serverdevel/airplay-esp32/docs/ru/index.md

---
title: ESP32 AirPlay 2 Receiver
hide:
  - navigation
---

[English](../index.md) | **Русский**

# AirPlay 2-приёмник на ESP32

**Добавьте AirPlay 2 к усилителю с помощью ESP32-S3 N16R8 и ЦАП PCM5102A.**

Эта прошивка превращает недорогую плату ESP32 в беспроводной AirPlay 2-приёмник.
Подключите его к усилителю или активным колонкам — устройство появится на iPhone, iPad
и Mac так же, как HomePod или телевизор с AirPlay.

Без облачного сервиса и отдельного приложения: выберите устройство и включите музыку.

!!! tip "Плата уже собрана? Установите прошивку прямо сейчас"

    Подключите её по USB и нажмите «Установить». Не нужны среда разработки,
    отдельные загрузки или командная строка: браузер сам запишет прошивку на плату.

<esp-web-install-button manifest="/airplay-esp32/firmware/esp32s3.json">
  <button slot="activate" class="md-button md-button--primary">Установить на ESP32-S3</button>
  <span slot="unsupported">Ваш браузер не поддерживает прошивку по USB. Используйте Chrome, Edge или Opera на компьютере.</span>
  <span slot="not-allowed">Для прошивки требуется защищённое соединение HTTPS.</span>
</esp-web-install-button>

Этот установщик предназначен только для официально поддерживаемой сборки
**ESP32-S3 N16R8 + PCM5102A**. Требуется настольная версия Chrome, Edge или Opera.

<div class="grid cards" markdown>

-   __Собираете впервые?__

    Купите две платы, соедините их и установите прошивку из браузера.

    [Начните здесь](getting-started/index.md)

-   __Проверьте оборудование__

    Для готовой прошивки нужны ESP32-S3 N16R8 и PCM5102A.

    [Поддержка оборудования](boards/index.md)

-   __Что-то не работает?__

    Нет сети настройки, звука или веб-страниц; возникают ошибки сборки.

    [Устранение неполадок](troubleshooting.md)

-   __Хотите изменить проект?__

    Среды сборки, аудиоконвейер и стек протоколов.

    [Архитектура](reference/architecture.md)

</div>

## Что получится

<p align="center">
  Собранный AirPlay-приёмник на ESP32-S3 и PCM5102A с разъёмом 3,5 мм<br>
  <em>Две платы и одна припаянная гребёнка; разъём 3,5 мм подключается к усилителю</em>
</p>

## Как это работает

```mermaid
flowchart LR
    P["iPhone / Mac"]
    W(("Wi‑Fi"))
    E["ESP32<br/><small>эта прошивка</small>"]
    D["ЦАП"]
    S["Аудиосистема"]

    P -->|AirPlay| W --> E -->|I2S| D -->|аналоговый сигнал| S

    classDef hi stroke:#26a69a,stroke-width:3px
    class E hi
```

Телефон обнаруживает в сети AirPlay-приёмник. ESP32 принимает зашифрованный поток,
декодирует и синхронизирует его, после чего передаёт звук по I2S на ЦАП. Аналоговый
выход ЦАП подключается к усилителю. Подробнее — в разделе [«Архитектура»](reference/architecture.md).

## Официально поддерживаемое оборудование

Готовые релизы этого форка собираются и проверяются только для следующей конфигурации:

- **ESP32-S3 N16R8** — 16 МБ flash и 8 МБ octal PSRAM
- **I2S-ЦАП PCM5102A** — подключённый к контактам GPIO10–GPIO14 по нашей схеме

Точные требования к плате, распиновка и положение перемычек приведены на странице
[«ESP32-S3 + PCM5102A»](boards/esp32s3-pcm5102a.md).

Профили других чипов и аудиоплат сохранены в исходном коде как наследие основного
проекта. В этом форке они не тестируются, не входят в релизы и официально не
поддерживаются. Перед самостоятельной сборкой прочитайте раздел
[«Поддержка оборудования»](boards/index.md).

## Возможности

- **AirPlay 2** — устройство отображается в Пункте управления и приложениях с поддержкой AirPlay
- **Интеграция с Apple Home («Дом»)** — приёмник добавляется в «Дом», принимает
  воспроизведение с HomePod и сохраняет сопряжение после перезагрузки
- **Декодирование ALAC и AAC** — музыка и звук в реальном времени, включая Siri и звонки
- **Мультирум** — синхронизация по PTP для одновременного воспроизведения на нескольких устройствах
- **Компенсация акустической задержки** — настройка от −1000 до +1000 мс через
  веб-интерфейс для совмещения звука с HomePod; применяется сразу и сохраняется
- **Веб-интерфейс** — настройка Wi‑Fi, имени устройства и других параметров из браузера
- **Обновления OTA** — обновление по сети; USB нужен только при первой прошивке
- **Выход 48 кГц** — дополнительное преобразование 44,1 → 48 кГц для совместимых ЦАП и мостов S/PDIF
- **Дисплеи** — OLED или цветной TFT 320×170 с названием трека, исполнителем и индикатором воспроизведения
- **Аппаратные кнопки** — воспроизведение/пауза, громкость и переключение треков

### Ограничения

- Только звук: без видео и фотографий AirPlay
- Одно устройство воспроизведения на одну плату ESP32
- Для стабильной передачи нужен уверенный сигнал Wi‑Fi

## Благодарности

- [Shairport Sync](https://github.com/mikebrady/shairport-sync) — эталонная реализация AirPlay
- [openairplay/airplay2-receiver](https://github.com/openairplay/airplay2-receiver) — реализация приёмника AirPlay 2 на Python
- [Espressif](https://github.com/espressif) — платформа ESP-IDF и библиотеки кодеков

## Правовая информация

**Только для некоммерческого использования.** Для коммерческого применения требуется
явное разрешение — см. файл [LICENSE](https://github.com/serverdevel/airplay-esp32/blob/homekit-0.2.1.4/LICENSE).

Это независимый проект, созданный на основе анализа протоколов. Он не связан с Apple Inc.,
не гарантирует совместимость с будущими версиями iOS или macOS и предоставляется без гарантий.
