serverdevel/airplay-esp32/docs/boards/xiao-esp32c5.md

**English** | [Русский](../ru/boards/xiao-esp32c5.md)

# Seeed XIAO ESP32-C5

!!! warning "Inherited and unverified profile"

    This page documents source code inherited from the upstream project. This fork does
    not test this hardware, publish a ready-to-flash image for it or provide official
    support. Build and validate it yourself at your own risk.

The Seeed XIAO ESP32-C5 is a RISC-V board with 8 MB flash, 8 MB PSRAM and **dual-band
WiFi 6**, which makes it attractive where 2.4 GHz is congested. Wire an external I2S DAC
such as a PCM5102A.

!!! warning "No Bluetooth A2DP"

    The ESP32-C5 has Bluetooth LE only, not Bluetooth Classic, so A2DP audio is not
    available on this board.

## Default I2S pins

| Function | GPIO | XIAO label |
| --- | --- | --- |
| Bit clock (BCK) | 8 | D8 |
| Word select (WS / LRCK) | 9 | D9 |
| Data in (DIN) | 10 | D10 |

Change them under **Board Configuration → Pin Configuration** in `menuconfig`.

## Building

There is no release image for this board — build and validate it yourself.

=== "PlatformIO"

    The official `platformio/espressif32` platform does **not** support the ESP32-C5, so
    every environment uses the community
    [pioarduino](https://github.com/pioarduino/platform-espressif32) platform, pinned in
    `platformio.ini`. It bundles ESP-IDF 5.5.5 and PlatformIO downloads it automatically
    on the first build — no extra setup needed.

    ```bash
    pio run -e esp32c5-xiao -t upload
    pio run -e esp32c5-xiao -t uploadfs
    ```

=== "ESP-IDF"

    ```bash
    idf.py set-target esp32c5
    idf.py -DSDKCONFIG_DEFAULTS="config/sdkconfig.defaults;config/sdkconfig.defaults.esp32c5" build flash monitor
    ```

## Related

- [Build environments](../reference/build-environments.md)
- [Custom board configuration](custom.md)
