serverdevel/airplay-esp32/docs/ru/features/bluetooth.md

[English](../../features/bluetooth.md) | **Русский**

# Bluetooth A2DP

!!! warning "Недоступно в поддерживаемом релизе этого форка"

    В поддерживаемой сборке ESP32-S3 N16R8 нет Bluetooth Classic, поэтому A2DP
    невозможен. Страница описывает унаследованный код для непроверенных профилей ESP32.

Платы ESP32-based могут принимать аудио через **Bluetooth Classic A2DP**, что позволяет любому телефону
планшет или ноутбук транслируют музыку без устройства Apple. Ресивер выглядит стандартно.
Динамик Bluetooth с метаданными AVRCP и регулировкой громкости.

!!! warning "Только ESP32"

    Bluetooth Classic существует только на оригинальном ESP32. ESP32-S3, S2 и C5 имеют
    Bluetooth LE или вообще ничего, поэтому A2DP там недоступен. Общий `esp32s3`
    сборка не содержит поддержки Bluetooth.

Стек Bluedroid используется для A2DP. Он очень жёсткий и на ОЗУ, и на флэш, вот почему
Сборки Bluetooth представляют собой отдельные среды, а не включаются повсюду.

## Как это работает

- AirPlay и Bluetooth сосуществуют в прошивке, но являются **взаимоисключающими во время выполнения**
- При подключении устройства Bluetooth работа AirPlay автоматически приостанавливается.
- При отключении AirPlay возобновляет работу.
- Обнаружение Bluetooth отключено во время активного сеанса AirPlay, поэтому телефон теряется.
  не могу прервать воспроизведение
- AVRCP обеспечивает синхронизацию громкости и метаданные дорожки (исполнитель, название, альбом) для отображения.
- Том Bluetooth сохраняется в NVS и восстанавливается при повторном подключении.

[Диаграмма состояний сосуществования](../reference/architecture.md#runtime-coexistence-rules)
показывает, как два протокола передаются друг другу.

## Сопряжение

Устройство объявляет то же имя, что и имя вашего устройства AirPlay, которое вы установили в Интернете.
интерфейс. Для сопряжения используется фиксированный PIN-код, `05032026` по умолчанию, который можно настроить в разделе
**Конфигурация Bluetooth** в `menuconfig`.

Secure Simple Pairing (SSP) можно дополнительно включить для устройств Bluetooth 2.1+, что
использует числовое подтверждение вместо PIN-кода. SSP нужен дисплей для отображения подтверждения
число, и это еще не реализовано.

## Среды сборки

| Среда сборки | Совет | Особенности |
| --- | --- | --- |
| `squeezeamp-bt` | SqueezeAMP | AirPlay + Bluetooth |
| `esparagus-audio-brick-bt` | Esparagus Audio Brick, версия ESP32 | AirPlay + Bluetooth + Ethernet |
| `esparagus-louder-bt` | Esparagus Louder | AirPlay + Bluetooth |
| `esp32wrover-dev` | Фринове ESP32-WROVER | AirPlay + Bluetooth, флэш-память 4 МБ |
| `smartamp` | SmartAmp | AirPlay + Bluetooth, флэш-память 4 МБ |

Bluetooth включается путем наложения `config/sdkconfig.defaults.bt` на настройки платы по умолчанию. Чтобы добавить это
на [пользовательскую плату](../boards/custom.md), включите этот файл в свой
Цепь `SDKCONFIG_DEFAULTS`.

Платы продаются как в ревизии ESP32, так и в версии ESP32-S3.
[Esparagus Audio Brick](../boards/esparagus-audio-brick.md) и Громче — есть `-bt`
среда только для ESP32. В версии S3 включать нечего.

## Кнопки при воспроизведении по Bluetooth

В отличие от AirPlay, [аппаратные кнопки](buttons.md) полностью работают с Bluetooth независимо от
настройки протокола, поскольку сквозной канал AVRCP передает команды воспроизведения/паузы и пропуска дорожки
изначально.
