serverdevel/airplay-esp32/dist/README-RU.md

# AirPlay 2 + Apple Home, версия 0.2.1.4

Сборка основана на `airplay-esp32` v0.2.1 и предназначена для платы
ESP32-S3 N16R8 с внешним PCM5102A. Она добавляет постоянную привязку
AirPlay-приёмника к Apple Home и ручную компенсацию постоянной задержки
домашнего кинотеатра в диапазоне от −1000 до +1000 мс.

Это позволяет добавить приёмник в приложение «Дом» и просить Siri на HomePod
добавить его к текущему воспроизведению. Это не превращает приёмник и HomePod
в стереопару: Apple разрешает стереопары только из совместимых моделей
HomePod. Здесь используется синхронная AirPlay 2 группа (multiroom).

## Какой файл использовать

Готовые файлы прошивки приложены к GitHub Release версии `0.2.1.4`.

- `airplay2-receiver-esp32s3-v0.2.1.4-ota.bin` — безопасное
  обновление через текущую веб-страницу устройства. Сохраняет Wi-Fi, имя и
  остальные настройки. Новая главная веб-страница встроена в OTA, поэтому это
  рекомендуемый вариант для обновления с версии 0.2.1.3.
- `airplay2-receiver-esp32s3-v0.2.1.4-spiffs.bin` — отдельный образ остальных
  веб-файлов. Для обновления с 0.2.1.3 не требуется.
- `airplay2-receiver-esp32s3-v0.2.1.4-full.bin` — полный образ на
  8 MiB для последовательной прошивки с адреса `0x0`. Он перезапишет NVS,
  поэтому Wi-Fi и настройки придётся вводить заново. Использовать для чистой
  установки или восстановления, только на ESP32-S3 с флеш-памятью не менее
  8 MiB (сборка настроена для 16 MiB).

## Обновление по Wi-Fi

1. Откройте IP-адрес приёмника в браузере.
2. В разделе **Firmware Update** выберите файл с окончанием `-ota.bin`.
3. Нажмите **Upload Firmware** и дождитесь перезагрузки.
4. Проверьте, что в сведениях о системе указана версия `0.2.1.4`, приёмник
   снова появился в меню AirPlay и обычное воспроизведение работает.

Новая главная страница с настройкой синхронизации встроена непосредственно в
OTA-образ. После обновления достаточно перезагрузить страницу браузера. Сбросить
привязку Apple Home также можно командой:

```bash
curl -X POST "http://IP_ПРИЁМНИКА/api/home/reset"
```

## Добавление в Apple Home

Для первичной привязки используйте один из домашних iPhone с современной
версией iOS. iPhone с iOS 16.3 для этого теста лучше не использовать.

1. iPhone, HomePod и ESP32 должны находиться в одной обычной локальной сети.
   Гостевая сеть и изоляция Wi-Fi-клиентов должны быть выключены.
2. В приложении «Дом» откройте настройки дома → **Колонки и телевизоры**
   (Allow Speaker & TV Access). Выберите доступ для устройств в той же сети и
   временно отключите требование пароля.
3. Нажмите `+` → **Добавить аксессуар** → **Другие варианты**.
4. Выберите имя AirPlay-приёмника и назначьте ему комнату, например
   «Гостиная». Название можно оставить «Кинотеатр».
5. Подождите 30–60 секунд и закройте/снова откройте «Дом», если устройство не
   появилось сразу.

После добавления попробуйте на HomePod:

- «Добавь кинотеатр»;
- «Играй также в кинотеатре»;
- «Перенеси музыку в кинотеатр».

Первая и вторая команды должны создать AirPlay-группу с HomePod; третья может
перенести воспроизведение вместо одновременной игры — это зависит от формулировки
Siri и выбранных комнат.

## Компенсация задержки домашнего кинотеатра

1. Запустите параллельное воспроизведение на HomePod и «Кинотеатре».
2. Откройте IP-адрес приёмника и найдите **AirPlay Synchronization**.
3. Если кинотеатр слышен раньше HomePod, задайте положительное значение. Если
   кинотеатр запаздывает, задайте отрицательное значение.
4. Нажмите **Apply**. Изменение применяется без перезагрузки; в этот момент
   возможен один короткий пропуск или пауза.
5. Сначала подбирайте шагом 50–100 мс, затем 5–10 мс. Значение сохраняется в
   NVS и продолжает действовать после перезагрузки.

Настройка исправляет постоянный сдвиг. Она не устраняет переменную задержку,
если ресивер домашнего кинотеатра сам меняет режим обработки сигнала.

## Если добавление не удалось

1. Удалите неудачно созданный аксессуар из «Дома», если он там появился.
2. Выполните сброс привязки кнопкой **Reset Home Pairing** или запросом
   `/api/home/reset` выше.
3. Перезагрузите ESP32 и повторите добавление с нового iPhone.
4. Откройте `http://IP_ПРИЁМНИКА/logs` и сохраните строки с метками
   `hap_`, `hap_pair_mgmt`, `hap_verify` и `rtsp`.

Базовая версия 0.2.1.3 проверена на реальном ESP32-S3 N16R8 с PCM5102A и
HomePod OS 27.0: добавление в Apple Home, перенос воспроизведения с HomePod и
параллельное воспроизведение в AirPlay-группе работают. В версии 0.2.1.4 к ней
добавлена ручная акустическая калибровка; точное значение нужно подобрать на
реальном домашнем кинотеатре.

## Контрольные суммы SHA-256

```text
06c5d24539da660a4b26f2fb9a90408fa9ecdc634a5125b49cdd1ece64787075  airplay2-receiver-esp32s3-v0.2.1.4-full.bin
a817c9d9be521f7bf0f7aff5aef759b827de46e934a4b7d1d3b2a331f714bdc1  airplay2-receiver-esp32s3-v0.2.1.4-ota.bin
eef89e670b03820c35afeaf72f536d5241e8ea5edc1c0faee7c680307429d073  airplay2-receiver-esp32s3-v0.2.1.4-spiffs.bin
```
