serverdevel/airplay-esp32/docs/ru/boards/esparagus-audio-brick.md

[English](../../boards/esparagus-audio-brick.md) | **Русский**

# Esparagus Audio Brick

!!! warning "Унаследованный непроверенный профиль"

    Эта страница описывает исходный код, унаследованный от основного проекта. Данный
    форк не тестирует эту плату, не публикует для неё готовый образ и не предоставляет
    официальную поддержку. Самостоятельная сборка и проверка выполняются на ваш риск.

[Esparagus Audio Brick](https://github.com/sonocotta/esparagus-media-center/?tab=readme-ov-file#esparagus-audio-brick-prototype)
построен на базе ЦАП и усилителя TI **TAS5825M** класса D. Как и SqueezeAMP, он
не нужен внешний ЦАП — подключайте динамики напрямую.

Плата существует в версиях **ESP32** и **ESP32-S3**. Аудио дизайн
то же самое; распиновки нет, и нет того, что могут сделать эти два чипа — см.
[Назначения GPIO по умолчанию](#default-gpio-assignments) и [Варианты](#variants).

Некоторые блоки оснащены TI **TAS5805M**, а не TAS5825M. Это то же самое
семья и тот же водитель, но это не одна и та же часть: см.
[Платы TAS5805M](#tas5805m-boards) за то, что она здесь делает и чего не делает.

## Функции

- TAS5825M со встроенным DSP и 15-полосным параметрическим эквалайзером (25 Гц – 16 кГц)
- Аппаратный регулятор громкости с настраиваемым максимальным уровнем
- Обнаружение неисправности динамика с автоматическим отключением звука и восстановлением
- Автоматическое управление состоянием питания (глубокий сон/ожидание/воспроизведение), управляемое состоянием сеанса AirPlay.
- флэш-память 8 МБ
- [Bluetooth A2DP](../features/bluetooth.md) только в версии **ESP32** — у S3 нет
  Bluetooth Классическая магнитола, поэтому сборки `-bt` для нее нет.
- [W5500 SPI Ethernet](../features/ethernet.md) с автоматическим аварийным переключением WiFi, на обоих
  редакции

## Прошивка

=== "Образ релиза"

    Этот форк не публикует готовый образ. Соберите и проверьте профиль самостоятельно.

=== "PlatformIO"

    ```bash
    # ESP32 — AirPlay + Ethernet
    pio run -e esparagus-audio-brick -t upload
    pio run -e esparagus-audio-brick -t uploadfs

    # ESP32 — AirPlay + Bluetooth + Ethernet
    pio run -e esparagus-audio-brick-bt -t upload
    pio run -e esparagus-audio-brick-bt -t uploadfs

    # ESP32-S3 — AirPlay + Ethernet (no Bluetooth on this chip)
    pio run -e esparagus-audio-brick-s3 -t upload
    pio run -e esparagus-audio-brick-s3 -t uploadfs

    # Serial monitor
    pio run -e esparagus-audio-brick -t monitor
    ```

=== "ESP-IDF"

    ```bash
    # ESP32 revision
    idf.py set-target esp32
    idf.py -DSDKCONFIG_DEFAULTS="config/sdkconfig.defaults;config/sdkconfig.defaults.esparagus-audio-brick" build

    # ESP32-S3 revision
    idf.py set-target esp32s3
    idf.py -DSDKCONFIG_DEFAULTS="config/sdkconfig.defaults;config/sdkconfig.defaults.esparagus-audio-brick-s3" build

    idf.py -p /dev/ttyUSB0 flash
    ```

## Назначения GPIO по умолчанию

У двух ревизий нет общей распиновки, поэтому выберите столбец, соответствующий вашей плате. ESP32
столбец — `config/sdkconfig.defaults.esparagus-audio-brick`, столбец S3
`config/sdkconfig.defaults.esparagus-audio-brick-s3`.

| Функция | ESP32 | ESP32-S3 | Заметки |
| --- | :-: | :-: | --- |
| I2S BCK | 26 | 14 | Битовые часы |
| I2S WS | 25 | 15 | Выбор слова (LRCLK) |
| I2S ДЕЛАТЬ | 22 | 16 | Последовательные аудиоданные |
| I2C ПДД | 21 | 8 | Управление ЦАП (TAS5825M) |
| I2C СКЛ | 27 | 9 | Управление ЦАП (TAS5825M) |
| Предупреждение ЦАП | 36 | 4 | TAS5825M выход предупреждения, вход |
| Ошибка динамика | 39 | 18 | TAS5825M FAULTZ, вход |
| Светодиод состояния | 12 | 21 | Адресный RGB |
| СПИ СКЛК | 18 | 12 | Совместно используется Ethernet и дисплей |
| СПИ МОСИ | 23 | 11 | Совместно используется Ethernet и дисплей |
| СПИ МИСО | 19 | 13 | Только Ethernet |
| Ethernet CS | 5 | 10 | W5500 |
| Ethernet ИНТ | 35 | 6 | W5500 |
| Ethernet РСТ | 14 | 5 | W5500 |
| Показать CS | 15 | 47 | SH1106 OLED |
| Дисплей постоянного тока | 4 | 38 | SH1106 OLED |
| Показать РСТ | 32 | 48 | SH1106 OLED |

!!! note "GPIOs 34–39 доступны только для ввода на ESP32"

    В версии ESP32 линии неисправности, предупреждения и прерывания Ethernet
    GPIOs 35–39, которые предназначены только для входа и не имеют внутренней подтяжки. Совет предоставляет
    внешние подтягивания. Версия S3 не имеет такого ограничения на используемые контакты.

Audio Brick Dual — это плата S3 с третьей распиновкой: у нее есть два усилителя и нет
FAULTZ возвращается к MCU, вместо этого тратя GPIO 18 и 17 на два включения ЦАП. См.
[Esparagus Audio Brick Dual](esparagus-audio-brick-dual-dac.md).

Сборка автоматически выбирает драйвер TAS58xx (`CONFIG_DAC_TAS58XX`). Водитель
автоматически определяет усилитель при запуске: 0x4C–0x4F для TAS5825M, 0x2C–0x2F для
ТАС5805М. Затем он подтверждает предположение по идентификатору кубика и предупреждает, если они не согласны.

## Платы TAS5805M

Некоторые кирпичи вместо этого имеют **TAS5805M**. Водитель обнаруживает его, управляет им и выдает
своя собственная последовательность инициализации, поэтому плата играет, а также ее громкость, отключение звука и 15-полосная биквадратная цепочка
все работает через страницу [Эквалайзер](#equaliser) точно так же, как на TAS5825M.

Две вещи не переносятся:

!!! warning "На TAS5805M нет дампов PPC3"

    Дамп воспроизводит *поток процесса*, что является функцией TAS5825M — TAS5805M не имеет
    регистр потока-выбора и размещает его коэффициенты по-другому, поэтому экспортируется дамп
    ибо одна часть будет писать мусор в другую. Водитель проверяет модель и
    пропускает файл, а не рискует. Эквивалента load не существует, поэтому
    [Полная настройка PPC3](#full-ppc3-tuning) просто не применима:
    Страница [Эквалайзер](#equaliser) содержит все доступные настройки, которые для большинства
    в любом случае сборки — это весь путь сигнала.

**Входной микшер** также предназначен только для TAS5825M. Суммирование в моно или подача одного канала на оба
Выходы выполняются в микшере DSP, и здесь реализован только микшер TAS5825M, поэтому
TAS5805M пропускает стереопару напрямую и записывает предупреждение, если его об этом попросят.
что-нибудь еще. Это также означает, что схема кроссовера не требует суммирования или одноканального подключения.
Feed — те, которые маршрутизируют пару как есть, все еще работают.

## Эквалайзер

Платы TAS5825M предоставляют доступ к 15 каскадным биквадратным секциям ЦАП через сеть устройства.
интерфейс на `/bq`, по одному фильтру на секцию, на выход и на усилитель. Каждый
Секция может быть пиковым фильтром, полкой, фильтром низких или высоких частот в шести выравниваниях, полосой
проход, метка, фазовый сдвиг или пять необработанных коэффициентов. Модели фильтров совпадают
PurePath Console 3, и коэффициенты пересчитываются всякий раз, когда частота дискретизации I2S
изменения. Два выхода микросхемы называются A и B — какой из них передает сигнал влево, вправо.
или сумма — это настройка маршрутизации, а не фиксированное назначение. A и B могут быть объединены или
настраивается отдельно. Редактирование только перерисовывает график ответов: **Применить** отправляет фильтры.
к усилителям, чтобы вы могли их услышать, а функция **Commit to flash** позволяет им пережить
перезагрузка. **Восстановить** возвращает то, что находится во флэш-памяти. Для формирования простого тона **Load
15-полосный эквалайзер** дополняет цепочку плоским графическим эквалайзером — по одной секции пиков на каждую.
полоса от 20 Гц до 16 кГц — остается установить только коэффициент усиления. Он заполняет форму и
ничего больше, поэтому усилитель слышит его только один раз.

Кроссоверы состоят из тех же секций, поэтому разделение на двухполосный динамик или сабвуфер просто необходимо.
проход верхних частот на одном усилителе и проход нижних частот на другом. **Создать кроссовер** делает это
для вас: выберите способ подключения драйверов — оба диапазона на одном усилителе, по одному усилителю на каждый.
динамик, высокочастотные динамики на одном усилителе и низкочастотные динамики на другом или сателлиты плюс
сабвуфер — затем частота разделения и выравнивание: Линквиц-Райли на 12 или
24 дБ на октаву, Баттерворта на 6, 12 или 24 или Бесселя на 12. Пишет фильтры
к каждому выходу, который касается разделения, устанавливает согласование группировки и входной маршрутизации и
оставляет фильтры включенными, поэтому ничего не слышно, пока они не будут применены. Apply всегда выдвигает все
усилители, поэтому кроссовер, объединяющий оба, никогда не сможет работать пополам. Макеты
правила подключения не предлагаются — мостовой усилитель не имеет отдельных A и B для
разделить поперек.

Более крутые выравнивания требуют больше слотов, поскольку секции располагаются каскадом. Линквиц-Райли — это два.
каскадировал Баттерворты половины своего порядка, поэтому LR2 - это два Баттерворта 1-го порядка - настоящие
полюса, которые схлопываются в один биквадрат при Q 0,5, тогда как LR4 представляет собой два полюса Баттерворта 2
секции при Q 0,707 и не могут быть сложены в одну. Вот почему 24 дБ на октаву
разделение показывает два раздела Баттерворта 2, а не один Линквиц-Райли 2: оба будут
наклон составляет 24 дБ на октаву, но только пара Баттерворта находится на 6 дБ ниже в углу,
именно это позволяет двум ветвям суммироваться. Две секции Linkwitz-Riley 2 будут
Там 12 дБ и сумма 6 дБ короче.

В каждом разделе также есть поле **Inv**, которое меняет полярность. Застройщик устанавливает это
сам и не предлагает его как выбор, потому что это решает расклад: на
В углу ветви расположены на 180° друг от друга с уровнем шума 12 дБ на октаву и требуют противоположной полярности для
сумма плоская, но они снова находятся в фазе на уровне 24, где инвертирование вместо этого приведет к образованию зазубрины.
Только одна часть ветки всегда несет его — полярность принадлежит цепи, и
поскольку секции умножаются, инвертирование четного их числа возвращает к нулю.
Коробка все еще там вручную для драйверов, подключенных не по фазе. Часть осталась на обходе
при отмеченном Inv происходит простая смена полярности и больше ничего не стоит.

### Уменьшение размера

**Подгонка к измерению...** превращает измеренный отклик в поправку. Загрузить частоту
экспорт ответа — текст REW, или любой файл с частотой и уровнем в первых двух
колонны — и слесарь ищет выступающие фильтры и полки, которые ее выравнивают,
затем записывает их в цепочку. Подгоняется только форма, а не абсолютный уровень.
График отклика получает два наложения: измерение в том виде, в котором оно было, и в том виде, в каком оно было раньше.
исправлено, поэтому можно оценить соответствие до того, как что-либо будет применено.

Три настройки имеют большее значение, чем остальные. Диапазон соответствия определяет, куда будут направлены усилия:
драйвер скатывается на своих концах на большую величину, чем может отменить любой фильтр, и выходит за пределы диапазона
Wide тратит фильтры на борьбу с тем, что вместо коррекции полосы, которую закрывает драйвер —
Страница говорит об этом, когда измерение уже значительно опустилось до нижнего предела. Сглаживающие наборы
сколько деталей гоняется, а шестая октава сохраняет режимы помещения, игнорируя
тонкая структура, которая движется вместе с микрофоном. Применяются ограничения повышения и понижения
к суммированной поправке, а не к какому-то одному фильтру, и результат сообщает, насколько
было использовано повышение, поэтому такая же величина может снизиться до уровня этого выхода, чтобы сохранить
высота над головой.

**Держать первые N секций** защищает начало цепи. Подгонка заменяет все
после этого отсчета, поэтому на динамике с двухканальным усилением оставьте кроссовер, измерьте каждую полосу
это и вписаться в то, что осталось; счет заполняется из любых низких или высоких проходов
уже сидит на вершине цепочки. Сохраняемые секции — это слоты, которых у установщика быть не может.
поэтому **Используемые фильтры** ограничиваются тем, что остается — кроссовер оставляет 24 дБ на октаву.
13 из 15. Установленные фильтры настроены так же, как и любой другой монтаж — ничего не слышно, пока
применяется, и ничего не сохраняется после перезагрузки до тех пор, пока не будет зафиксировано.

Каждый усилитель имеет свою собственную входную маршрутизацию: стереопара как есть, суммированная с
`(L+R)/2` или один канал подается на оба выхода. Мостовой усилитель управляет одним голосом
катушка, поэтому на нее всегда подается один канал и по умолчанию используется сумма; группировка является неявной
стерео вариант не предлагается. Объединенный график ответов вверху страницы.
отображает каждый активный выход вместе, поэтому можно определить разброс кроссовера по обоим усилителям.
читать как одну картинку.

**Показать сумму выходных данных** добавляет еще одну кривую к этому графику. Питание выходов
отдельные драйверы добавляются как векторы, а не как кривые, поэтому две ветви, каждая из которых выглядит правильно
в одиночку все еще может отменить то место, где они перекрываются - и обе кривые тоже выглядят одинаково
в обход, поэтому его легко пропустить. Сумма берется по комплексу
Вместо этого ответ: кроссовер правильный, когда он ровно проходит поворот, а провал
значит ветки ругаются, поэтому одной из них нужен **Inv**. След знает
только фильтры, а не динамики, их расстояние или помещение, так что это показывает, что
кроссовер нацелен на то, а не на то, что услышит микрофон.

Уровни задаются в разделе Volume. Мастер — это том AirPlay, который перемещается.
все вместе. Под ним каждый выход имеет свой собственный уровень и приглушение, применяемое в
Входной микшер DSP опережает фильтры — поэтому они только ослабляют и не требуют затрат на фильтр.
высота над головой. Используйте их для сопоставления драйверов с разной чувствительностью. Уровни и приглушения берут
вступают в силу немедленно и сохраняются в NVS независимо от фиксации фильтра.

## Полная конфигурация PPC3

!!! info "Только TAS5825M"

    Весь этот раздел относится к платам, оснащенным TAS5825M. Кирпич TAS5805M не имеет
    поток процесса для воспроизведения и игнорирует эти файлы \u2014 см.
    [Платы TAS5805M](#tas5805m-boards).

Страница эквалайзера охватывает пятнадцать биквадов на канал, кроссовер и уровни.
это весь путь сигнала для большинства сборок. Настроенный дамп из TI PurePath Console 3
идет дальше: это полная конфигурация устройства — тактирование, формат I2S, процесс
поток выбирает и каждый коэффициент — чтобы он дошел до блоков, которые веб-интерфейс не делает
разоблачить. Сюда входят потоки, карта коэффициентов которых TI никогда не публиковала, потому что дамп
воспроизводит записи в собственный регистр TI, а не адреса, которые нам нужно знать.

При загрузке драйвер ищет дамп на SPIFFS и, если он есть, воспроизводит его *вместо этого.
из* встроенной последовательности инициализации. PPC3 записывает каждый коэффициент со скоростью потока.
экспортируется, поэтому настройка 48 кГц, воспроизводимая на частоте 44,1 кГц, снижает каждый угол примерно на 8%: имя
файл по его скорости, и драйвер выбирает тот, который соответствует тому, что он воспроизводит.

| Файл | Применяется к |
| --- | --- |
| `/spiffs/hf/tas5825m_fw-44100.bin` | единственный усилитель, или первый из двух, на 44,1 кГц |
| `/spiffs/hf/tas5825m_fw-48000.bin` | то же, на частоте 48 кГц |
| `/spiffs/hf/tas5825m_fw0-44100.bin` | первый усилитель на плате с двумя ЦАП, частота 44,1 кГц |
| `/spiffs/hf/tas5825m_fw1-44100.bin` | второй усилитель на плате с двумя ЦАП, частота 44,1 кГц |

Отбросьте суффикс `-<rate>` — `tas5825m_fw.bin`, `tas5825m_fw0.bin` — для дампа, который
должен обслуживать каждую ставку. Эти имена являются запасными, их ищут только один раз.
файлы, зависящие от скорости, совпадают, поэтому установка с одной скоростью продолжает работать без изменений. Процесс
поток — это функция TAS5825M, поэтому драйвер ищет что-либо из этого только в этой части —
см. [платы TAS5805M](#tas5805m-boards).

Чтобы установить один:

1. Настройте деталь в PPC3 и экспортируйте либо журнал I2C (`.cfg`), либо заголовок C для каждого
   частота дискретизации, которую вы хотите охватить.
2. Преобразуйте его:
   ```bash
   python3 components/dac_tas58xx/ppc3_convert.py my_tuning_44k1.cfg -o tas5825m_fw-44100.bin
   ```
Журнал, который управляет обоими усилителями, содержит записи для каждого, поэтому выберите тот, у которого
   `--dev 98` или `--dev 9a` и преобразуйте его дважды.
3. Скопируйте результат в `data/hf/` для последовательной прошивки или загрузите его через WiFi:
   ```bash
   curl -X POST "http://<device-ip>/api/fs/upload?path=/spiffs/hf/tas5825m_fw-44100.bin" \
        --data-binary @tas5825m_fw-44100.bin
   ```
4. Перезагрузитесь.

Удалите файл, чтобы вернуться к встроенному потоку.

!!! warning

    Дамп владеет конфигурацией, поэтому драйвер перестает писать свой собственный путь сигнала.
    по умолчанию и вместо этого доверяет настройке. Неправильно указана тактовая частота или формат I2S.
    и эта роль не сыграет — в первый раз оставьте последовательную консоль подключенной.

Биквадратные адреса идентичны во всех документированных потоках как на TAS5825M, так и на
TAS5805M, поэтому страница эквалайзера продолжает работать поверх дампа. Дамп, который выбирает
недокументированный поток является исключением: ничто не гарантирует, что его коэффициенты будут жить там, где
страница ожидает их.

## Варианты

| Среда сборки | Чип | Bluetooth | Образ релиза | Заметки |
| --- | --- | :-: | :-: | --- |
| `esparagus-audio-brick` | ESP32 | — | — | AirPlay + Ethernet |
| `esparagus-audio-brick-bt` | ESP32 | да | — | Добавляет Bluetooth A2DP |
| `esparagus-audio-brick-s3` | ESP32-S3 | — | — | Распиновка S3, PSRAM, на этом чипе нет Bluetooth Classic |
| `esparagus-audio-brick-dual-dac` | ESP32-S3 | — | — | [Dual](esparagus-audio-brick-dual-dac.md), два усилителя: стерео по 0x4C, второй по 0x4D |
| `esparagus-audio-brick-dual-uac` | ESP32-S3 | — | — | [Dual](esparagus-audio-brick-dual-dac.md) в качестве аудиоустройства USB |

Ни один вариант в этой таблице не публикуется и не тестируется данным форком.

Bluetooth Classic существует только на оригинальном ESP32, поэтому в сборке `-bt` нет S3.
эквивалент; блок S3 подключается к сети через Ethernet или WiFi. У Dual есть два
усилители и собственная распиновка, а также получает [свою страницу](esparagus-audio-brick-dual-dac.md).

### Esparagus Louder

Esparagus Louder — это усилитель той же конструкции, но на собственной плате.

| Среда сборки | Чип | Bluetooth | Образ релиза |
| --- | --- | :-: | :-: |
| `esparagus-louder` | ESP32 | — | — |
| `esparagus-louder-bt` | ESP32 | да | — |
| `esparagus-louder-s3` | ESP32-S3 | — | — |

```bash
pio run -e esparagus-louder-s3 -t upload
pio run -e esparagus-louder-s3 -t uploadfs
```

## См. также

- [Bluetooth A2DP](../features/bluetooth.md)
- [Ethernet (W5500)](../features/ethernet.md)
- [Среды сборки](../reference/build-environments.md)
