serverdevel/airplay-esp32/docs/getting-started/shopping-list.md

**English** | [Русский](../ru/getting-started/shopping-list.md)

# Shopping list

You need two boards and a short pin header. Everything is available on AliExpress or
Amazon for under $10 total, excluding tools.

| Component | What to search for | Price |
| --- | --- | --- |
| **ESP32-S3 N16R8 dev board** | "ESP32-S3 N16R8" — verify 16 MB flash and 8 MB octal PSRAM | ~$5 |
| **PCM5102A DAC board** | "PCM5102A I2S DAC" — the small purple board with a 3.5 mm jack | ~$3 |
| **Straight 2.54 mm male header** | "Male pin header 2.54mm single row" — 1×6 or longer, cut to size | ~$0.50 |

You also need a fine-tip soldering iron, electronics solder, a multimeter and a
small piece of Kapton tape, electrical tape or thin PET sheet to insulate the
3.5 mm audio jack from the underside of the ESP32.

> [!WARNING]
> The ready-to-flash image is specific to **ESP32-S3 N16R8 + PCM5102A**. Do not buy a
> generic ESP32, ESP32-S2, ESP32-C5 or an integrated audio board expecting the release
> image to work on it.

## Check the DAC board

Verify the solder bridges on your PCM5102A are in the same position as the
picture below: **1-L, 2-L, H-3 and 4-L**. Boards ship with varying defaults,
and the wrong bridge position is a common cause of silence. The additional
bridge beside SCK is covered in the [assembly guide](assembly.md).

<p align="center">
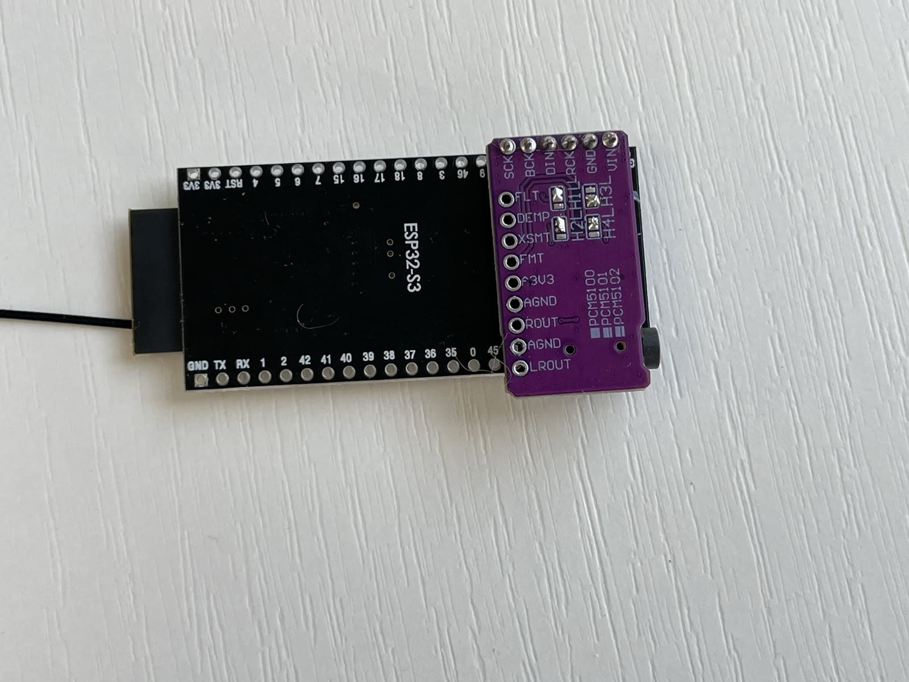
[picture p2: docs/assets/build/pcm5102a-mode-jumpers.jpg]
PCM5102A DAC board showing the expected solder bridge positions
  <br>
  <em>PCM5102A configured as 1-L, 2-L, 3-H and 4-L</em>
</p>

## Optional extras

| Component | What it adds | Page |
| --- | --- | --- |
| 0.96" OLED, SSD1306 / SH1106 / SSD1309 | Track title, artist, progress bar | [OLED display](../features/oled-display.md) |
| 320×170 ST7789 TFT | Full-colour metadata screen (ESP32-S3) | [TFT display](../features/tft-display.md) |
| Momentary push buttons | Play/pause, volume, track skip | [Hardware buttons](../features/buttons.md) |
| W5500 SPI Ethernet module | Wired networking with WiFi failover | [Ethernet](../features/ethernet.md) |
