serverdevel/airplay-esp32/docs/ru/getting-started/shopping-list.md

[English](../../getting-started/shopping-list.md) | **Русский**

# Что купить

Понадобятся две платы и короткая штыревая гребёнка. Всё это можно найти на AliExpress
или Amazon, общая стоимость без учёта инструментов — менее $10.

| Компонент | Что искать | Примерная цена |
| --- | --- | --- |
| **Отладочная плата ESP32-S3 N16R8** | `ESP32-S3 N16R8` — проверьте 16 МБ flash и 8 МБ octal PSRAM | ~$5 |
| **Плата ЦАП PCM5102A** | `PCM5102A I2S DAC` — маленькая фиолетовая плата с разъёмом 3,5 мм | ~$3 |
| **Прямая однорядная штыревая гребёнка 2,54 мм** | `Male pin header 2.54mm single row` — 1×6 или длиннее, лишнее можно отрезать | ~$0,50 |

Также понадобятся паяльник с тонким жалом, припой для электроники, мультиметр и
небольшой кусочек каптоновой или изоляционной ленты либо тонкого ПЭТ-листа. Прокладка
должна изолировать корпус аудиоразъёма 3,5 мм от контактов на нижней стороне ESP32.

> [!WARNING]
> Готовый образ предназначен только для **ESP32-S3 N16R8 + PCM5102A**. Не покупайте
> обычный ESP32, ESP32-S2, ESP32-C5 или готовую аудиоплату в расчёте на совместимость
> с опубликованной прошивкой.

## Проверьте плату ЦАП

Убедитесь, что перемычки на PCM5102A расположены так же, как на фотографии:
**1-L, 2-L, H-3 и 4-L**. Заводское положение перемычек различается, а неверная
настройка часто приводит к отсутствию звука. Дополнительная перемычка возле SCK
описана в [руководстве по сборке](assembly.md).

<p align="center">
  Перемычки режима на плате ЦАП PCM5102A<br>
  <em>PCM5102A с настройкой 1-L, 2-L, 3-H и 4-L</em>
</p>

## Дополнительные компоненты

| Компонент | Что он добавляет | Страница |
| --- | --- | --- |
| OLED 0,96 дюйма на SSD1306 / SH1106 / SSD1309 | Название трека, исполнитель и индикатор воспроизведения | [OLED-дисплей](../features/oled-display.md) |
| TFT 320×170 на ST7789 | Полноцветный экран с метаданными (ESP32-S3) | [TFT-дисплей](../features/tft-display.md) |
| Тактовые кнопки | Воспроизведение/пауза, громкость и переключение треков | [Аппаратные кнопки](../features/buttons.md) |
| Ethernet-модуль W5500 SPI | Проводная сеть с автоматическим переходом на Wi‑Fi | [Ethernet](../features/ethernet.md) |
