serverdevel/airplay-esp32/docs/assets/3d-models/esp32-airplay-rear-cover-standard.stl

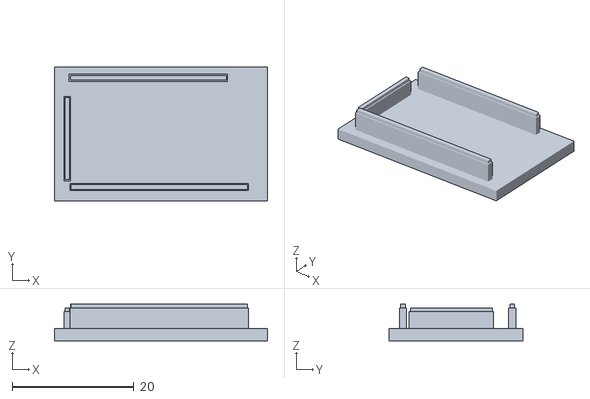
[picture p3: CAD file, 2026-10-16]
docs/assets/3d-models/esp32-airplay-rear-cover-standard.stl
35.0 x 22.0 x 6.00
