serverdevel/airplay-esp32/docs/assets/3d-models/esp32-airplay-enclosure.stl

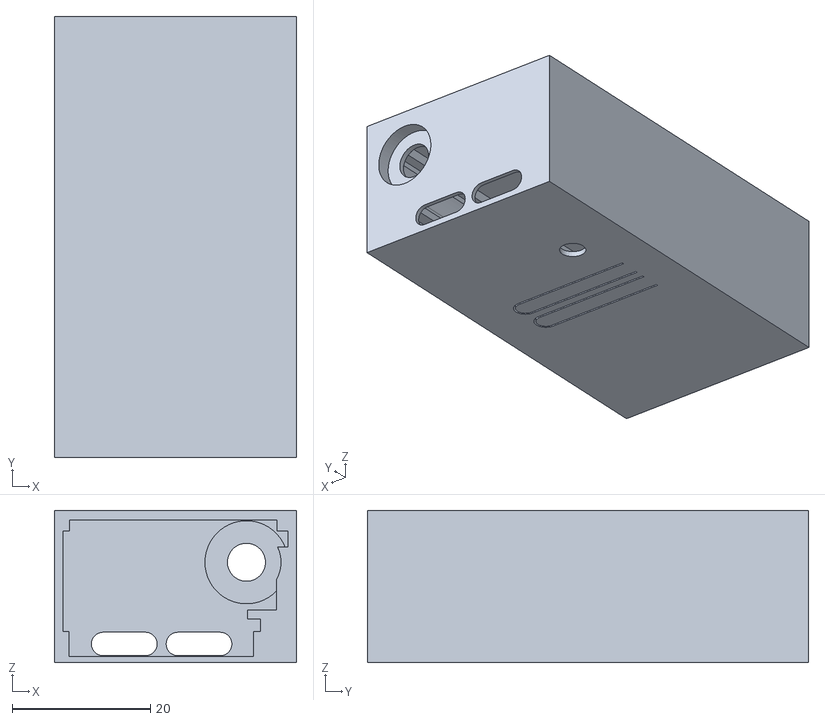
[picture p4: CAD file, 2026-10-16]
docs/assets/3d-models/esp32-airplay-enclosure.stl
35.0 x 63.7 x 22.0
