serverdevel/airplay-esp32/(list of files, cad)

Other CAD files:
docs/assets/3d-models/esp32-airplay-rear-cover-tight.stl
