serverdevel/airplay-esp32/docs/ru/reference/build-environments.md

[English](../../reference/build-environments.md) | **Русский**

# Среды сборки

Здесь перечислены среды PlatformIO из `platformio.ini`. Этот форк собирает, проверяет и
публикует только **`esp32s3`** — ESP32-S3 N16R8 с PCM5102A. Все остальные записи на
этой странице являются унаследованными, непроверенными профилями без образов в релизе.

## Общие платы

| Среда сборки | Чип | Флэш | Заметки |
| --- | --- | --- | --- |
| `esp32s3` | ESP32-S3 | 16 МБ | По умолчанию. Внешний ЦАП I2S, например PCM5102A |
| `esp32s3-jtag` | ESP32-S3 | 16 МБ | Расширяет `esp32s3`, загружает через встроенный USB JTAG |
| `waveshare-esp32s3` | ESP32-S3 | 16 МБ | Расположение контактов Waveshare ESP32-S3 |
| `esp32c5-xiao` | ESP32-C5 | 8 МБ | Seeed XIAO, нуждается в платформе Pioarduino сообщества |
| `esp32wrover-dev` | ESP32 | 4 МБ | Freenove WROVER, включает Bluetooth |

## Платы усилителей

| Среда сборки | Чип | ЦАП | Флэш | Bluetooth |
| --- | --- | --- | --- | :-: |
| `squeezeamp` | ESP32 | ТАС5756 | 8 МБ | — |
| `squeezeamp-bt` | ESP32 | ТАС5756 | 8 МБ | да |
| `squeezeamp-4m` | ESP32 | ТАС5756 | 4 МБ | — |
| `esparagus-audio-brick` | ESP32 | ТАС58хх | 8 МБ | — |
| `esparagus-audio-brick-bt` | ESP32 | ТАС58хх | 8 МБ | да |
| `esparagus-audio-brick-s3` | ESP32-S3 | ТАС58хх | 8 МБ | — |
| `esparagus-audio-brick-dual-dac` | ESP32-S3 | 2× ТАС58хх | 8 МБ | — |
| `esparagus-audio-brick-dual-uac` | ESP32-S3 | 2× ТАС58хх | 8 МБ | — |
| `esparagus-louder` | ESP32 | ТАС58хх | 8 МБ | — |
| `esparagus-louder-bt` | ESP32 | ТАС58хх | 8 МБ | да |
| `esparagus-louder-s3` | ESP32-S3 | ТАС58хх | 8 МБ | — |
| `smartamp` | ESP32 | — | 4 МБ | да |

Каждая плата Esparagus оснащена усилителем TAS58xx: TAS5825M или TAS5805M.
Драйвер считывает идентификатор кристалла при запуске и настраивает тот, который находит, поэтому
среде сборки не обязательно знать, какая часть находится на плате.

В средах с двумя ЦАП используется [Audio Brick Dual](../boards/esparagus-audio-brick-dual-dac.md)
с двумя усилителями: стерео по адресу I2C по адресу 0x4C и второй по 0x4D, подключенный либо как
мостовой (PBTL) моновыход или в качестве второй стереопары. `-dual-uac` добавляет звук USB в
та же плата.

## Платы аудиодок-станции Sonocotta

[HiFi](../boards/hifi-esp32.md), [Громкий](../boards/loud-esp32.md),
Все семейства [Amped](../boards/amped-esp32.md) и [Louder](../boards/louder-esp32.md)
выпускаются в форме `-esp32` с разъемом Ethernet и разъемом OLED, а также в форме `-esparagus`.
форма без того и другого. Bluetooth Classic существует только на оригинальном ESP32, поэтому S3 нет.
В среде есть вариант `-bt`.

| Среда сборки | Чип | ЦАП/усилитель | Флэш | Bluetooth |
| --- | --- | --- | --- | :-: |
| `hifi-esp32` | ESP32 | PCM5100 | 8 МБ | — |
| `hifi-esp32-bt` | ESP32 | PCM5100 | 8 МБ | да |
| `hifi-esparagus` | ESP32 | PCM5100 | 8 МБ | — |
| `hifi-esparagus-bt` | ESP32 | PCM5100 | 8 МБ | да |
| `hifi-esp32-s3` | ESP32-S3 | PCM5100 | 8 МБ | — |
| `hifi-esparagus-s3` | ESP32-S3 | PCM5100 | 8 МБ | — |
| `loud-esp32` | ESP32 | MAX98357A | 8 МБ | — |
| `loud-esp32-bt` | ESP32 | MAX98357A | 8 МБ | да |
| `loud-esparagus` | ESP32 | 2 × MAX98357A | 8 МБ | — |
| `loud-esparagus-bt` | ESP32 | 2 × MAX98357A | 8 МБ | да |
| `loud-esp32-s3` | ESP32-S3 | 2 × MAX98357A | 8 МБ | — |
| `esparagus-echo` | ESP32-S3 | 2 × MAX98357A | 8 МБ | — |
| `amped-esp32` | ESP32 | PCM5100 + TPA31xx | 8 МБ | — |
| `amped-esp32-bt` | ESP32 | PCM5100 + TPA31xx | 8 МБ | да |
| `amped-esparagus` | ESP32 | PCM5100 + TPA31xx | 8 МБ | — |
| `amped-esparagus-bt` | ESP32 | PCM5100 + TPA31xx | 8 МБ | да |
| `amped-esp32-s3` | ESP32-S3 | PCM5100 + TPA31xx | 8 МБ | — |
| `louder-esp32` | ESP32 | ТАС5805М | 8 МБ | — |
| `louder-esp32-bt` | ESP32 | ТАС5805М | 8 МБ | да |
| `louder-esp32-plus` | ESP32 | ТАС5825М | 8 МБ | — |
| `louder-esp32-plus-bt` | ESP32 | ТАС5825М | 8 МБ | да |
| `louder-esp32-s3` | ESP32-S3 | ТАС5805М | 8 МБ | — |
| `louder-esp32-s3-plus` | ESP32-S3 | ТАС5825М | 8 МБ | — |

## Цели без среды PlatformIO

Они имеют настройки по умолчанию sdkconfig и собираются напрямую через ESP-IDF.

| Цель | Сдкконфиг | Статус |
| --- | --- | --- |
| ESP32-S2 | `config/sdkconfig.defaults.esp32s2` | Унаследованный непроверенный профиль; образ не публикуется |
| ESP32-P4 | `config/sdkconfig.defaults.esp32p4` | Экспериментальный |

```bash
idf.py set-target esp32s2
idf.py -DSDKCONFIG_DEFAULTS="config/sdkconfig.defaults;config/sdkconfig.defaults.esp32s2" build
```

## Публикуемый образ релиза

Workflow релиза собирает только **`esp32s3`**. В браузерном установщике используется
только соответствующий манифест `docs/firmware/esp32s3.json`. Ни стабильные релизы,
ни бета-версии не должны публиковать профили других плат.

Все остальные среды сохранены только как справочные материалы основного проекта и
основа для ручного портирования. Даже успешная компиляция такого профиля не означает,
что он официально поддерживается.

## Как объединяются файлы sdkconfig

Вся конфигурация платы находится в **`config/`**. Сгенерированный `sdkconfig` остается на
корень проекта — это артефакт сборки и игнорируется git.

Среды составляют свою конфигурацию путем объединения файлов sdkconfig слева направо с помощью
более поздние файлы переопределяют более ранние:

```ini
board_build.cmake_extra_args =
    "-DSDKCONFIG_DEFAULTS=config/sdkconfig.defaults;config/sdkconfig.defaults.squeezeamp;config/sdkconfig.defaults.bt"
```

Здесь сначала идут общие настройки по умолчанию, затем конфигурация платы SqueezeAMP, а затем
Наложение Bluetooth. Добавление `config/sdkconfig.defaults.bt` в конец любой цепочки плат ESP32
как включается Bluetooth.

!!! warning "Удалить кэшированный файл sdkconfig после изменения настроек по умолчанию"

    Созданный файл `sdkconfig.<env>` кэшируется в корне проекта. Если вы измените какой-либо
    по умолчанию, удалите его перед пересборкой, иначе старые значения будут повторно использованы без уведомления.

## Общие команды

```bash
pio run -e <env> -t build      # Build
pio run -e <env> -t upload     # Build and flash over USB
pio run -e <env> -t uploadfs   # Flash the SPIFFS image from data/
pio run -e <env> -t monitor    # Serial monitor at 115200 baud
pio run -e <env> -t menuconfig # Kconfig configuration
```

Чтобы определить собственную среду, не касаясь `platformio.ini`, см.
[Пользовательская конфигурация платы](../boards/custom.md).
