serverdevel/airplay-esp32/(commit log)

2026-10-16 docs: add printable enclosure rear covers
    [esp32-airplay-enclosure.stl, esp32-airplay-rear-cover-standard.stl, esp32-airplay-rear-cover-tight.stl]
2026-10-16 docs: add photographed soldering guide
2026-10-16 docs: make assembly photos render on GitHub
2026-10-16 docs: limit official support to ESP32-S3 N16R8
