serverdevel/airplay-esp32/(notices)

Notices in the files:
README.md:
License: Non-Commercial
